anszom/avr-vusb-keyboard/README

A mostly-complete USB-based keyboard controller using atmega16 with V-USB.

Full description here: http://kuku.eu.org/?projects/keyboard/index
