anszom/avr-vusb-keyboard/hw/README

Project files for KiCad, made with kicad version 0.20131208+bzr4024.
