anszom/avr-vusb-keyboard/hw/kbd.kicad_pcb

## KiCad design hw/kbd.kicad_pcb (2016-05-22)

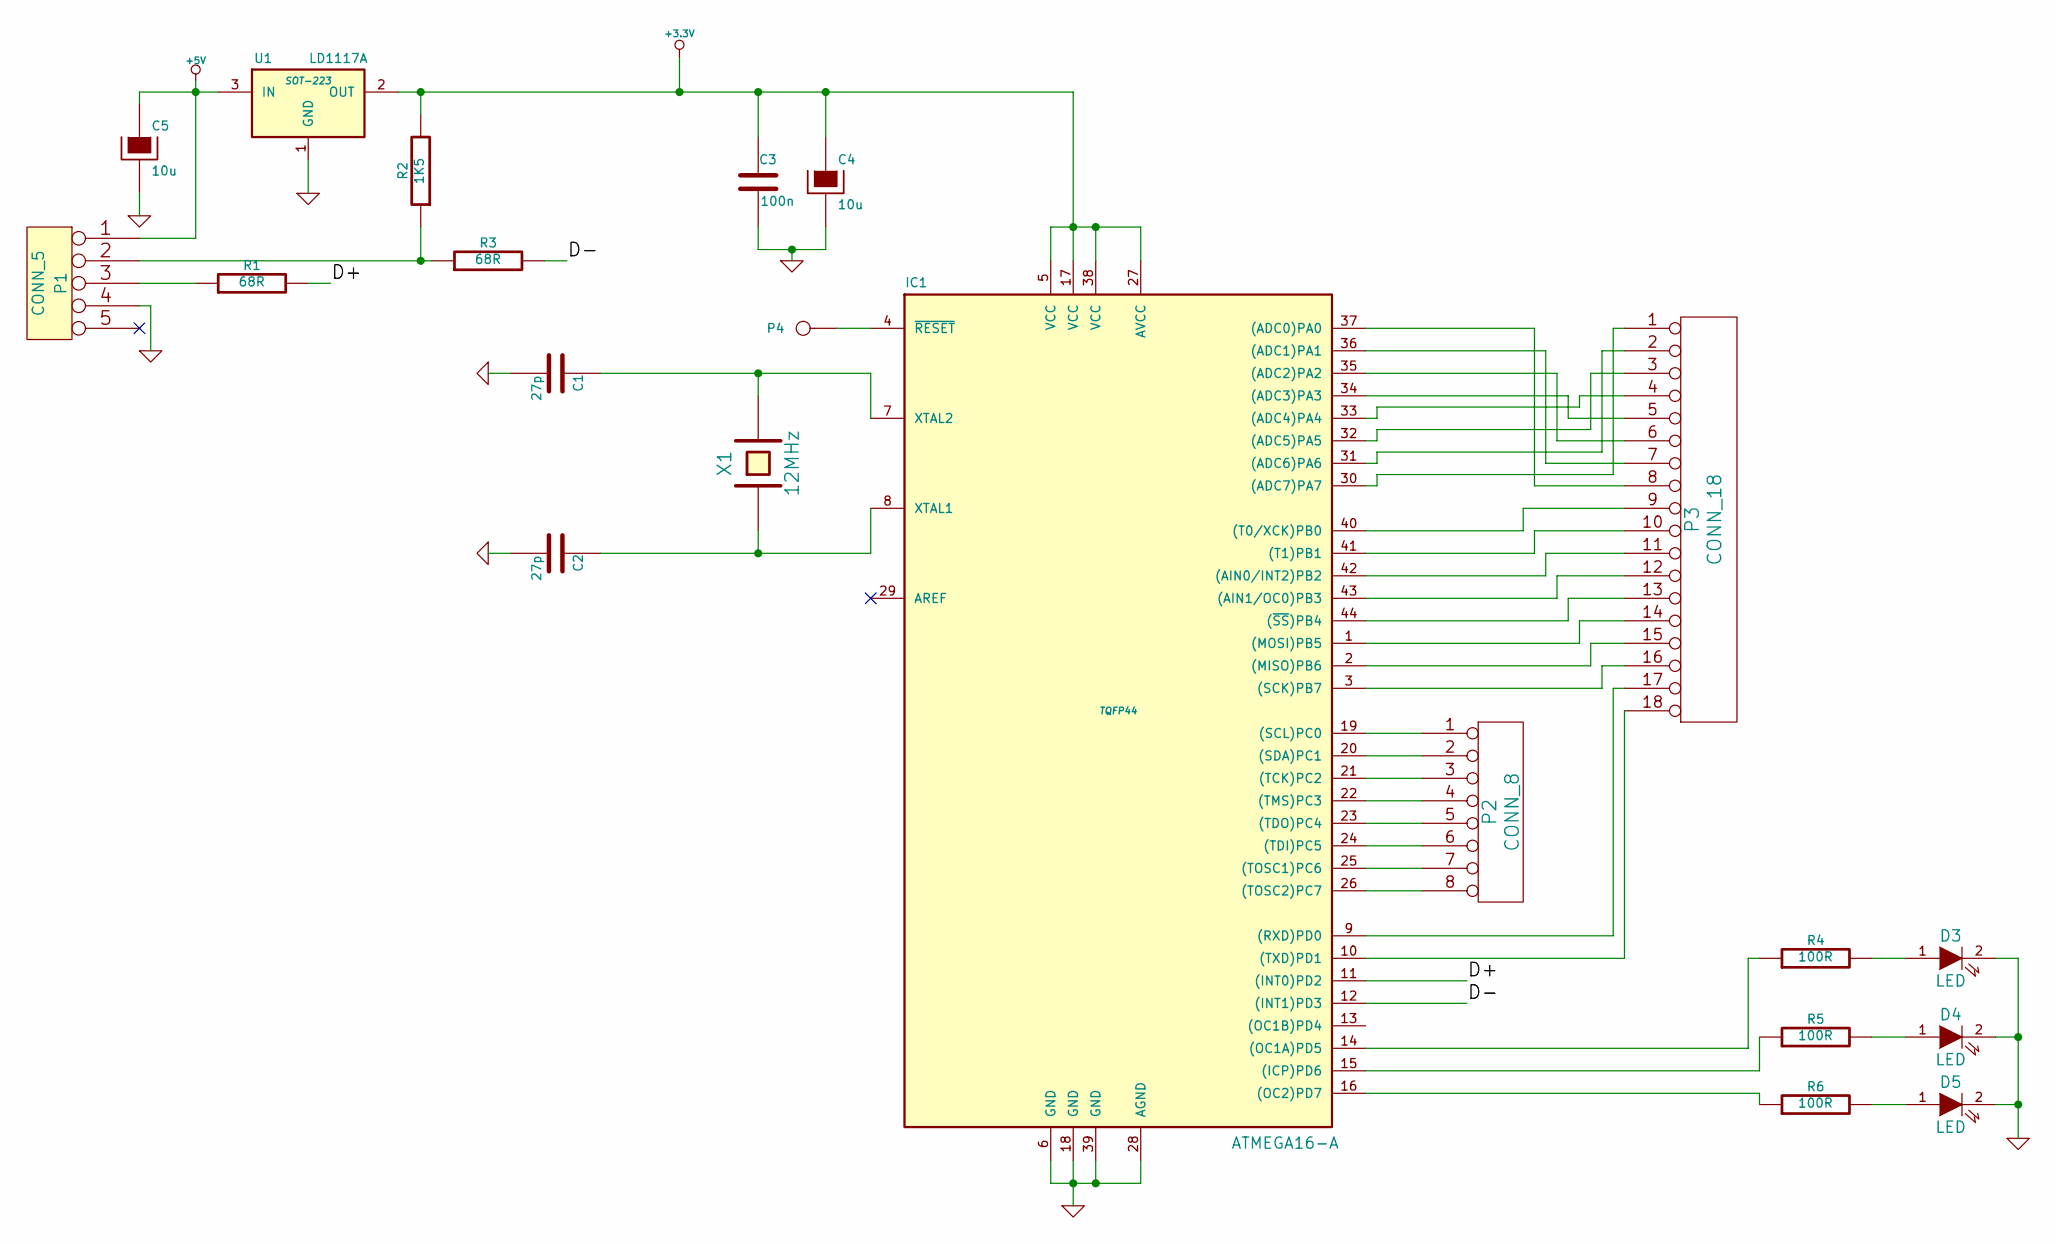
[picture p5: schematic kbd.sch]

Parts:
C1, C2: 27p
C3: 100n
C4, C5: 10u
D3, D4, D5: LED
IC1: ATMEGA16-A; TQFP44
P1: CONN_5
P2: CONN_8
P3: CONN_18
P4: CONN_1
R1, R3: 68R
R2: 1K5
R4, R5, R6: 100R
U1: LD1117A; SOT-223
X1: 12MHz

Connections:
+3.3V: C3.1, C4.1, IC1.5 (VCC), IC1.17 (VCC), IC1.27 (AVCC), IC1.38 (VCC), R2.2, U1.2 (OUT)
+5V: C5.1, P1.1, U1.3 (IN)
/D+: IC1.11 ((INT0)PD2), R1.2
/D-: IC1.12 ((INT1)PD3), R3.2
GND: C1.2, C2.2, C3.2, C4.2, C5.2, D3.2 (K), D4.2 (K), D5.2 (K), IC1.6 (GND), IC1.18 (GND), IC1.28 (AGND), IC1.39 (GND), P1.4, U1.1 (GND)
unnamed: IC1.9 ((RXD)PD0), P3.17
unnamed: IC1.44 ((~SS~)PB4), P3.13
unnamed: IC1.1 ((MOSI)PB5), P3.14
unnamed: IC1.2 ((MISO)PB6), P3.15
unnamed: IC1.3 ((SCK)PB7), P3.16
unnamed: IC1.10 ((TXD)PD1), P3.18
unnamed: IC1.4 (~RESET), P4.1
unnamed: IC1.41 ((T1)PB1), P3.10
unnamed: IC1.22 ((TMS)PC3), P2.4
unnamed: IC1.21 ((TCK)PC2), P2.3
unnamed: IC1.20 ((SDA)PC1), P2.2
unnamed: IC1.19 ((SCL)PC0), P2.1
unnamed: IC1.40 ((T0/XCK)PB0), P3.9
unnamed: IC1.42 ((AIN0/INT2)PB2), P3.11
unnamed: IC1.43 ((AIN1/OC0)PB3), P3.12
unnamed: D5.1 (A), R6.2
unnamed: D4.1 (A), R5.2
unnamed: D3.1 (A), R4.2
unnamed: IC1.23 ((TDO)PC4), P2.5
unnamed: P1.2, R2.1, R3.1
unnamed: P1.3, R1.1
unnamed: IC1.37 ((ADC0)PA0), P3.8
unnamed: IC1.36 ((ADC1)PA1), P3.7
unnamed: IC1.35 ((ADC2)PA2), P3.6
unnamed: IC1.30 ((ADC7)PA7), P3.1
unnamed: IC1.14 ((OC1A)PD5), R4.1
unnamed: IC1.15 ((ICP)PD6), R5.1
unnamed: IC1.16 ((OC2)PD7), R6.1
unnamed: IC1.26 ((TOSC2)PC7), P2.8
unnamed: IC1.25 ((TOSC1)PC6), P2.7
unnamed: IC1.24 ((TDI)PC5), P2.6
unnamed: IC1.32 ((ADC5)PA5), P3.3
unnamed: IC1.34 ((ADC3)PA3), P3.5
unnamed: IC1.33 ((ADC4)PA4), P3.4
unnamed: IC1.31 ((ADC6)PA6), P3.2
unnamed: C1.1, IC1.7 (XTAL2), X1.2
unnamed: C2.1, IC1.8 (XTAL1), X1.1

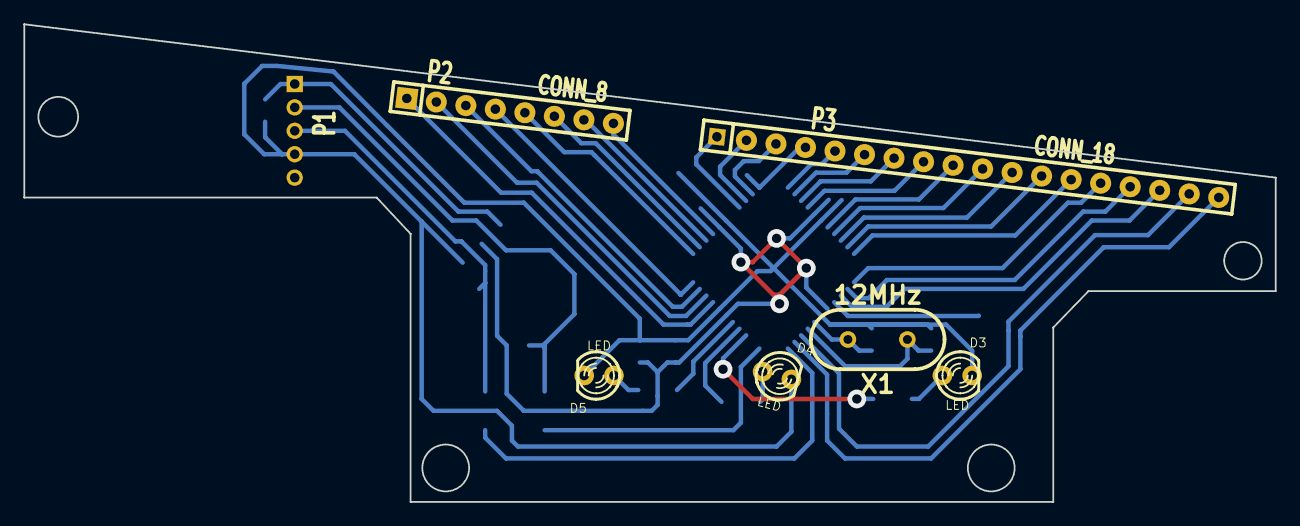
[picture p6: board kbd.kicad_pcb from above]

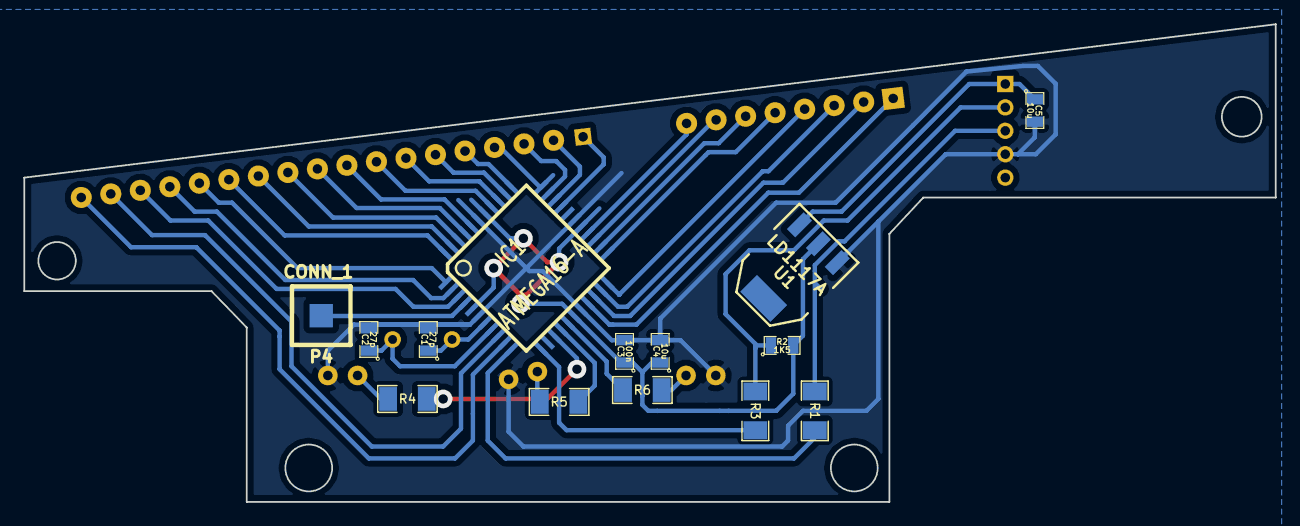
[picture p7: board kbd.kicad_pcb from below]

Board: 2 copper layers, 106.9 x 40.8 mm, 21 parts (14 on the bottom side), 42 nets.
