anszom/avr-vusb-keyboard/sw/hid_descriptor.h

// Z:\home\qq\MSDEV\qk2.h


char ReportDescriptor[104] = {
    0x05, 0x01,                    // USAGE_PAGE (Generic Desktop)
    0x09, 0x06,                    // USAGE (Keyboard)
    0xa1, 0x01,                    // COLLECTION (Application)
    0x85, 0x01,                    //   REPORT_ID (1)
    0x05, 0x07,                    //   USAGE_PAGE (Keyboard)
    0x19, 0xe0,                    //   USAGE_MINIMUM (Keyboard LeftControl)
    0x29, 0xe7,                    //   USAGE_MAXIMUM (Keyboard Right GUI)
    0x15, 0x00,                    //   LOGICAL_MINIMUM (0)
    0x25, 0x01,                    //   LOGICAL_MAXIMUM (1)
    0x75, 0x01,                    //   REPORT_SIZE (1)
    0x95, 0x08,                    //   REPORT_COUNT (8)
    0x81, 0x02,                    //   INPUT (Data,Var,Abs)
    0x95, 0x05,                    //   REPORT_COUNT (5)
    0x75, 0x01,                    //   REPORT_SIZE (1)
    0x05, 0x08,                    //   USAGE_PAGE (LEDs)
    0x19, 0x01,                    //   USAGE_MINIMUM (Num Lock)
    0x29, 0x03,                    //   USAGE_MAXIMUM (Scroll Lock)
    0x91, 0x02,                    //   OUTPUT (Data,Var,Abs)
    0x95, 0x01,                    //   REPORT_COUNT (1)
    0x75, 0x03,                    //   REPORT_SIZE (3)
    0x91, 0x03,                    //   OUTPUT (Cnst,Var,Abs)
    0x95, 0x06,                    //   REPORT_COUNT (6)
    0x75, 0x08,                    //   REPORT_SIZE (8)
    0x15, 0x00,                    //   LOGICAL_MINIMUM (0)
    0x25, 0x65,                    //   LOGICAL_MAXIMUM (101)
    0x05, 0x07,                    //   USAGE_PAGE (Keyboard)
    0x19, 0x00,                    //   USAGE_MINIMUM (Reserved (no event indicated))
    0x29, 0x65,                    //   USAGE_MAXIMUM (Keyboard Application)
    0x81, 0x00,                    //   INPUT (Data,Ary,Abs)
    0xc0,                          // END_COLLECTION
    0x05, 0x0c,                    // USAGE_PAGE (Consumer Devices)
    0x09, 0x01,                    // USAGE (Consumer Control)
    0xa1, 0x01,                    // COLLECTION (Application)
    0x85, 0x02,                    //   REPORT_ID (2)
    0x05, 0x0c,                    //   USAGE_PAGE (Consumer Devices)
    0x15, 0x00,                    //   LOGICAL_MINIMUM (0)
    0x25, 0x01,                    //   LOGICAL_MAXIMUM (1)
    0x75, 0x01,                    //   REPORT_SIZE (1)
    0x95, 0x0a,                    //   REPORT_COUNT (10)
    0x09, 0xb6,                    //   USAGE (Scan Previous Track)
    0x09, 0xb5,                    //   USAGE (Scan Next Track)
    0x09, 0xea,                    //   USAGE (Volume Down)
    0x09, 0xe9,                    //   USAGE (Volume Up)
    0x09, 0xe2,                    //   USAGE (Mute)
    0x09, 0xcd,                    //   USAGE (Play/Pause)
    0x0a, 0x96, 0x01,              //   USAGE (AL Internet Browser )
    0x0a, 0x21, 0x02,              //   USAGE (AC Search)
    0x0a, 0x8a, 0x01,              //   USAGE (AL Email Reader )
    0x0a, 0x92, 0x01,              //   USAGE (AL Calculator )
    0x81, 0x02,                    //   INPUT (Data,Var,Abs)
    0xc0                           // END_COLLECTION
};
