anszom/avr-vusb-keyboard/(commit log)

2016-05-22 hardware: initial commit
    [kbd.kicad_pcb, kbd.sch]
2016-05-22 firmware: import vusb-20121206
    [tiny45-rc.sch, with-series-diodes.sch, with-vreg.sch, with-zener.sch]
2016-05-22 Add USB wakeup support.
    1. Prepare custom USB configuration descriptor with USBATTR_REMOTEWAKE
    2. Use the USB_COUNT_SOF feature from VUSB. This requires:
    3. Change the VUSB's interrupt config from D+ to D- trigger
